udawat/IMU-9DoF-AHRS/README.md

IMU-9DoF-AHRS
=============

Explore Labs' 9 DoF IMU with Invensense's MPU-9150, Freescale Semiconductor's Pressure Sensor MPL3115A2 and Measurement Specialties' Humidity Sensor HTU21D and an optional GPS connector.
