udawat/IMU-9DoF-AHRS/IMU 9DoF AHRS Schematic.pdf

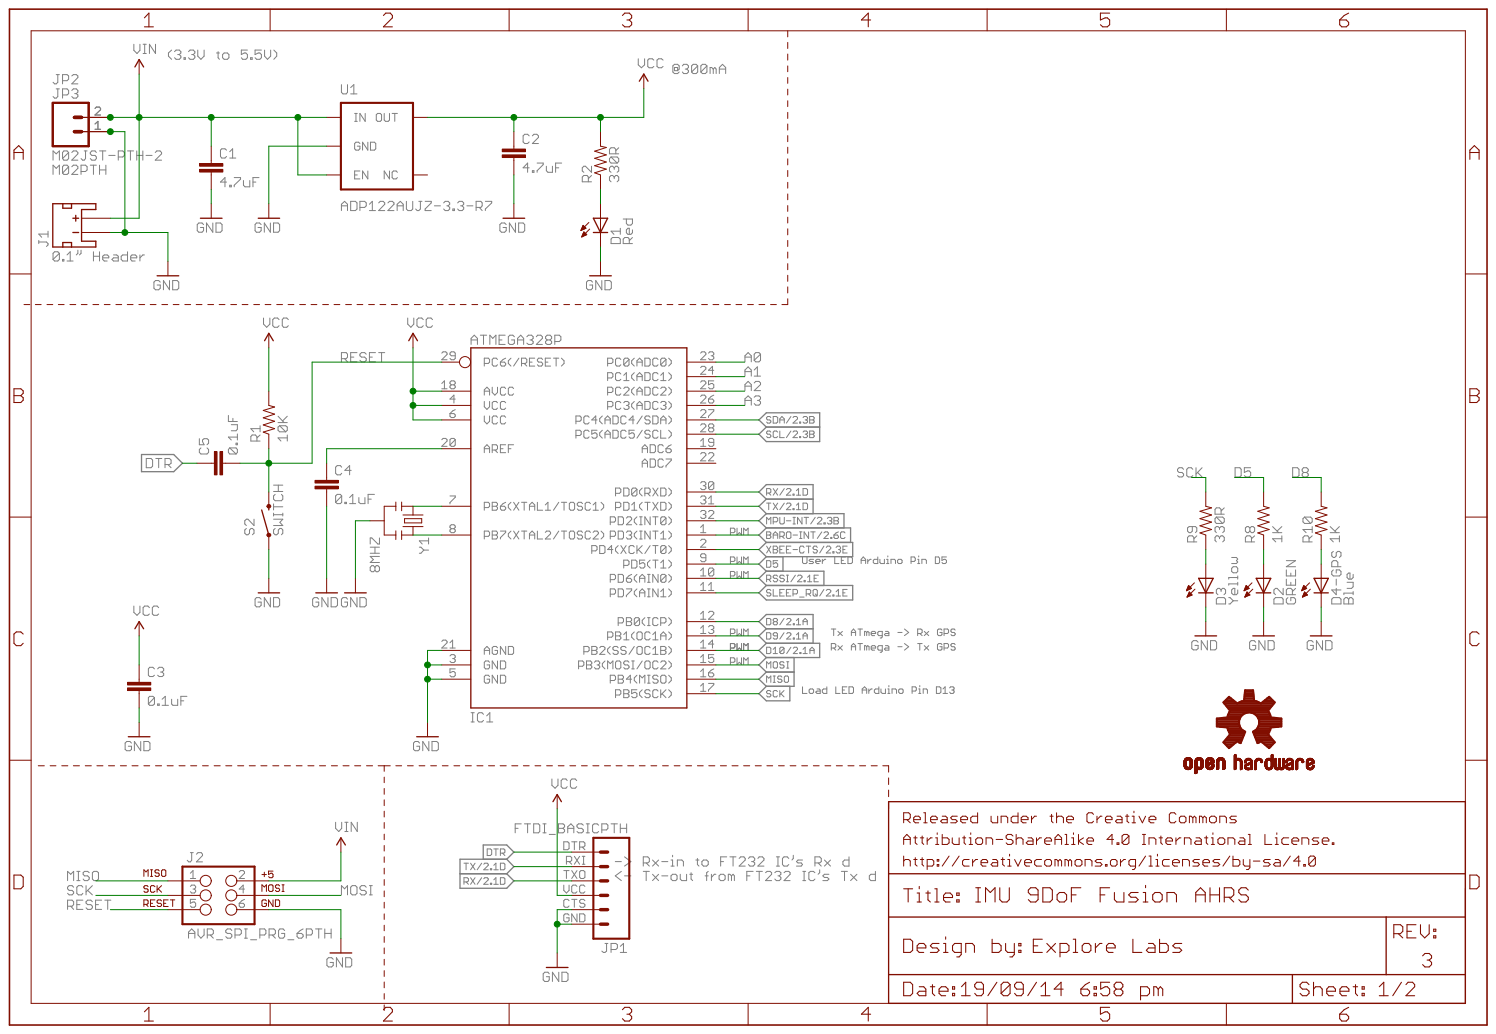
[picture p1: page 1]

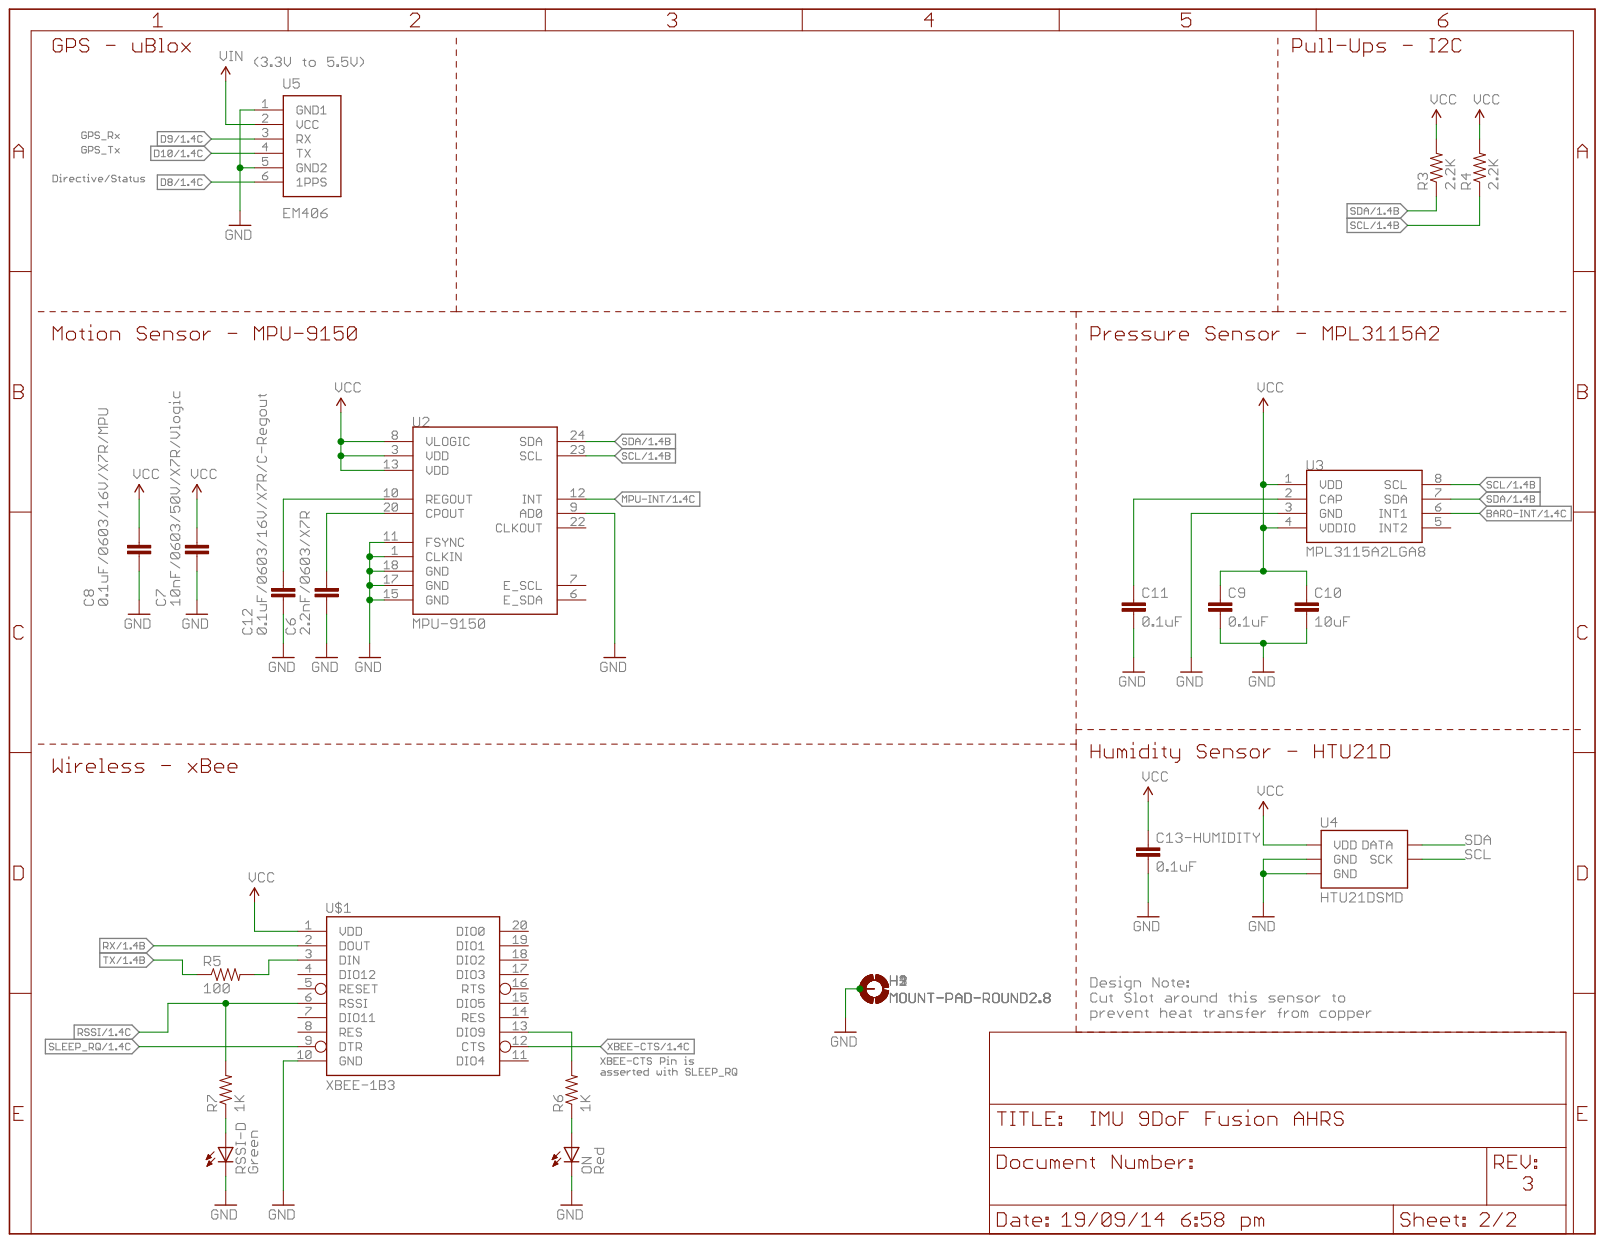
[picture p2: page 2]
