udawat/IMU-9DoF-AHRS/IMU 9DoF AHRS.brd

## EAGLE design IMU 9DoF AHRS.brd (2014-09-23)

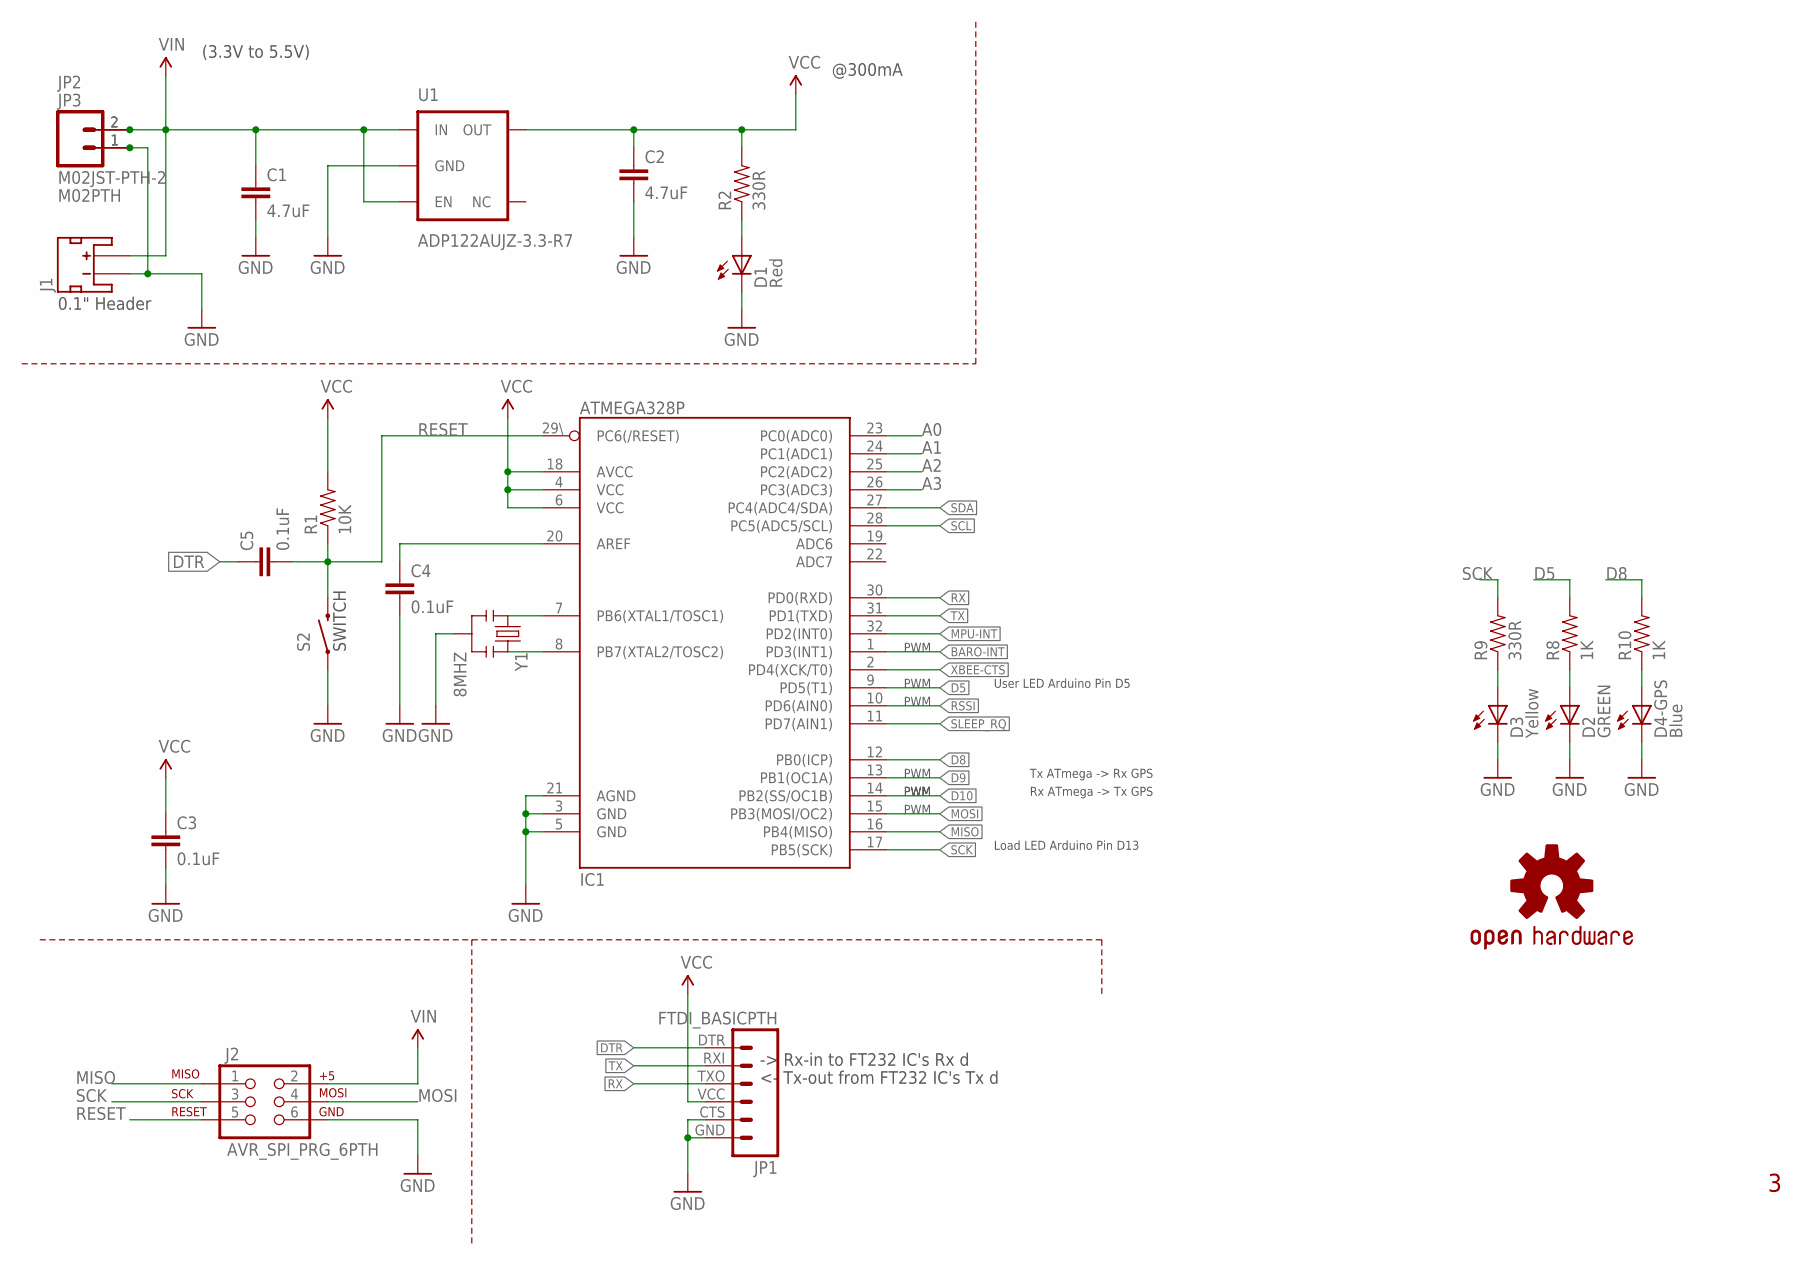
[picture p3: schematic IMU 9DoF AHRS.sch, sheet 1]

Parts:
C1, C2: 4.7uF; 0603-CAP
C3, C4, C5: 0.1uF; 0603-CAP
D1: Red; CHIPLED_0805
D2: GREEN; CHIPLED_0805
D3: Yellow; CHIPLED_0805
D4-GPS: Blue; CHIPLED_0805
IC1: ATMEGA328P; TQFP32-08
J1: JST_2MM_MALE; JST-2-SMD
J2: AVR_SPI_PRG_6PTH; 2X3
JP1: FTDI_BASICPTH; FTDI_BASIC
JP2: M02JST-PTH-2; JST-2-PTH
JP3: M02PTH; 1X02
LOGO4: OSHW-LOGOBOTTOM; OSHW-LOGO-M-BOTTOM
R1: 10K; 0603-RES
R2, R9: 330R; 0603-RES
R8, R10: 1K; 0603-RES
S2: SWITCH-MOMENTARY-2-SMD-1101NE; TACTILE-SWITCH-1101NE
U1: ADP122AUJZ-3.3-R7; SOT-23-5
Y1: 8MHZ; RESONATOR-SMD

Connections:
A0: IC1.23 (PC0(ADC0))
A1: IC1.24 (PC1(ADC1))
A2: IC1.25 (PC2(ADC2))
A3: IC1.26 (PC3(ADC3))
BARO-INT: IC1.1 (PD3(INT1)); also elsewhere on the board
D5: IC1.9 (PD5(T1)), R8.2
D8: IC1.12 (PB0(ICP)), R10.2; also elsewhere on the board
D9: IC1.13 (PB1(OC1A)); also elsewhere on the board
D10: IC1.14 (PB2(SS/OC1B)); also elsewhere on the board
DTR: C5.1, JP1.DTR (1)
GND: C1.2, C2.2, C3.2, C4.2, D1.C, D2.C, D3.C, D4-GPS.C, IC1.3 (GND), IC1.5 (GND), IC1.21 (AGND), J1.1 (-), J2.6, JP1.CTS (5), JP1.GND (6), JP2.1, JP3.1, S2.P$1 (1), U1.2 (GND), Y1.2; also elsewhere on the board
MISO: IC1.16 (PB4(MISO)), J2.1
MOSI: IC1.15 (PB3(MOSI/OC2)), J2.4
MPU-INT: IC1.32 (PD2(INT0)); also elsewhere on the board
unnamed: IC1.8 (PB7(XTAL2/TOSC2)), Y1.3
unnamed: IC1.7 (PB6(XTAL1/TOSC1)), Y1.1
unnamed: D3.A, R9.1
unnamed: C4.1, IC1.20 (AREF)
unnamed: D2.A, R8.1
unnamed: D1.A, R2.1
unnamed: D4-GPS.A, R10.1
RESET: C5.2, IC1.29\ (PC6(/RESET)), J2.5, R1.1, S2.P$2 (2)
RSSI: IC1.10 (PD6(AIN0)); also elsewhere on the board
RX: IC1.30 (PD0(RXD)), JP1.TXO (3); also elsewhere on the board
SCK: IC1.17 (PB5(SCK)), J2.3, R9.2
SCL: IC1.28 (PC5(ADC5/SCL)); also elsewhere on the board
SDA: IC1.27 (PC4(ADC4/SDA)); also elsewhere on the board
SLEEP_RQ: IC1.11 (PD7(AIN1)); also elsewhere on the board
TX: IC1.31 (PD1(TXD)), JP1.RXI (2); also elsewhere on the board
VCC: C2.1, C3.1, IC1.4 (VCC), IC1.6 (VCC), IC1.18 (AVCC), JP1.VCC (4), R1.2, R2.2, U1.5 (OUT); also elsewhere on the board
VIN: C1.1, J1.2 (+), J2.2, JP2.2, JP3.2, U1.1 (IN), U1.3 (EN); also elsewhere on the board
XBEE-CTS: IC1.2 (PD4(XCK/T0)); also elsewhere on the board

Notes on the sheet:
(3.3V to 5.5V)
@300mA
-> Rx-in to FT232 IC's Rx d
<- Tx-out from FT232 IC's Tx d
Load LED Arduino Pin D13
Tx ATmega -> Rx GPS
Rx ATmega -> Tx GPS
SWITCH
PWM
0.1" Header
User LED Arduino Pin D5

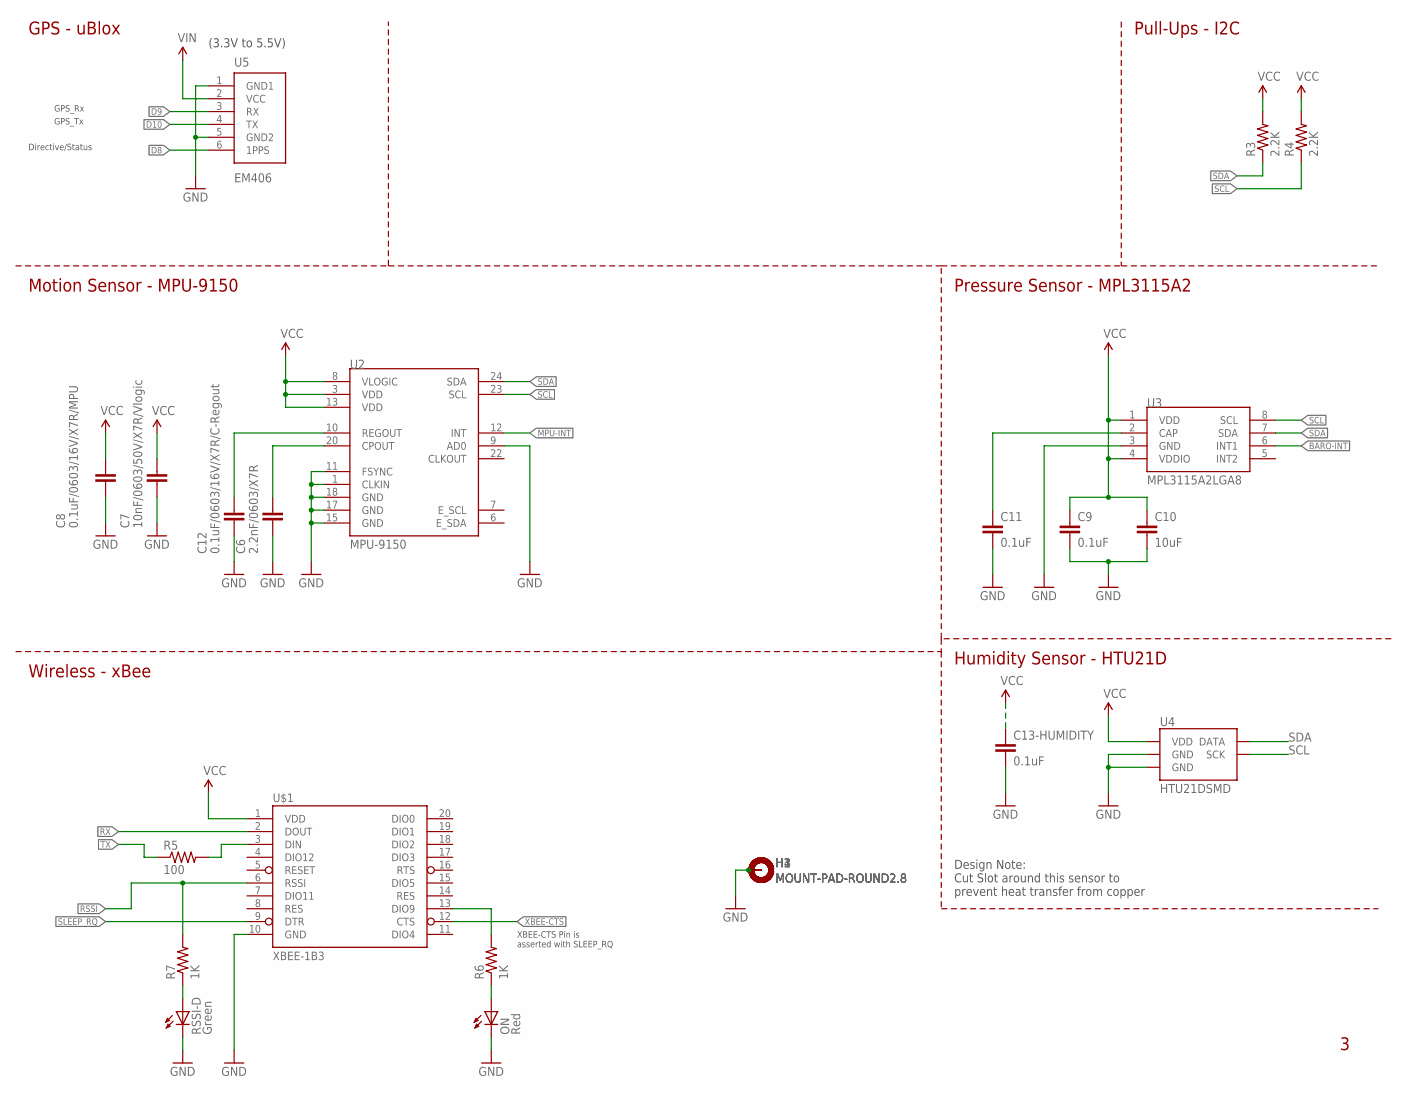
[picture p4: schematic IMU 9DoF AHRS.sch, sheet 2]

Parts:
C6: 2.2nF/0603/X7R; 0603-CAP
C7: 10nF/0603/50V/X7R/Vlogic; 0603-CAP
C8: 0.1uF/0603/16V/X7R/MPU; 0603-CAP
C9, C11, C13-HUMIDITY: 0.1uF; 0603-CAP
C10: 10uF; 0805
C12: 0.1uF/0603/16V/X7R/C-Regout; 0603-CAP
H1, H2, H3, H4: MOUNT-PAD-ROUND2.8; 2,8-PAD
ON: Red; CHIPLED_0805
R3, R4: 2.2K; 0603-RES
R5: 100; 0603-RES
R6, R7: 1K; 0603-RES
RSSI-D: Green; CHIPLED_0805
U2: MPU-9150QFN-24-NP; QFN-24-NP
U3: MPL3115A2LGA8; LGA8
U4: HTU21DSMD; HTU21D
U5: EM406
U$1: XBEE-1B3; XBEE-SMD

Connections:
BARO-INT: U3.6 (INT1); also elsewhere on the board
D8: U5.6 (1PPS); also elsewhere on the board
D9: U5.3 (RX); also elsewhere on the board
D10: U5.4 (TX); also elsewhere on the board
GND: C6.2, C7.2, C8.2, C9.2, C10.2, C11.2, C12.2, C13-HUMIDITY.2, H1.B2,8, H2.B2,8, H3.B2,8, H4.B2,8, ON.C, RSSI-D.C, U2.1 (CLKIN), U2.9 (AD0), U2.11 (FSYNC), U2.15 (GND), U2.17 (GND), U2.18 (GND), U3.3 (GND), U4.7 (GND), U4.GND, U5.1 (GND1), U5.5 (GND2), U$1.10 (GND); also elsewhere on the board
MPU-INT: U2.12 (INT); also elsewhere on the board
unnamed: C6.1, U2.20 (CPOUT)
unnamed: R5.2, U$1.3 (DIN)
unnamed: R7.1, RSSI-D.A
unnamed: R6.2, U$1.13 (DIO9)
unnamed: C12.1, U2.10 (REGOUT)
unnamed: ON.A, R6.1
unnamed: C11.1, U3.2 (CAP)
RSSI: R7.2, U$1.6 (RSSI); also elsewhere on the board
RX: U$1.2 (DOUT); also elsewhere on the board
SCL: R4.1, U2.23 (SCL), U3.8 (SCL), U4.SCK; also elsewhere on the board
SDA: R3.1, U2.24 (SDA), U3.7 (SDA), U4.DATA; also elsewhere on the board
SLEEP_RQ: U$1.9 (DTR); also elsewhere on the board
TX: R5.1; also elsewhere on the board
VCC: C7.1, C8.1, C9.1, C10.1, C13-HUMIDITY.1, R3.2, R4.2, U2.3 (VDD), U2.8 (VLOGIC), U2.13 (VDD), U3.1 (VDD), U3.4 (VDDIO), U4.VDD, U$1.1 (VDD); also elsewhere on the board
VIN: U5.2 (VCC); also elsewhere on the board
XBEE-CTS: U$1.12 (CTS); also elsewhere on the board

Notes on the sheet:
XBEE-CTS Pin is asserted with SLEEP_RQ
MPU-9150
Humidity Sensor - HTU21D
Pressure Sensor - MPL3115A2
Pull-Ups - I2C
Wireless - xBee
GPS_Rx
GPS_Tx
Directive/Status
Design Note: Cut Slot around this sensor to prevent heat transfer from copper
(3.3V to 5.5V)
GPS - uBlox
Motion Sensor - MPU-9150

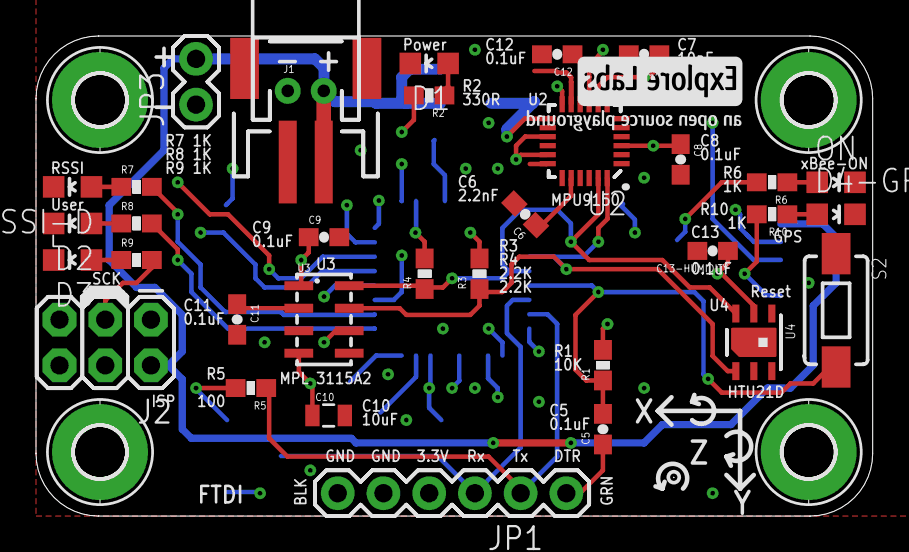
[picture p5: board IMU 9DoF AHRS.brd from above]

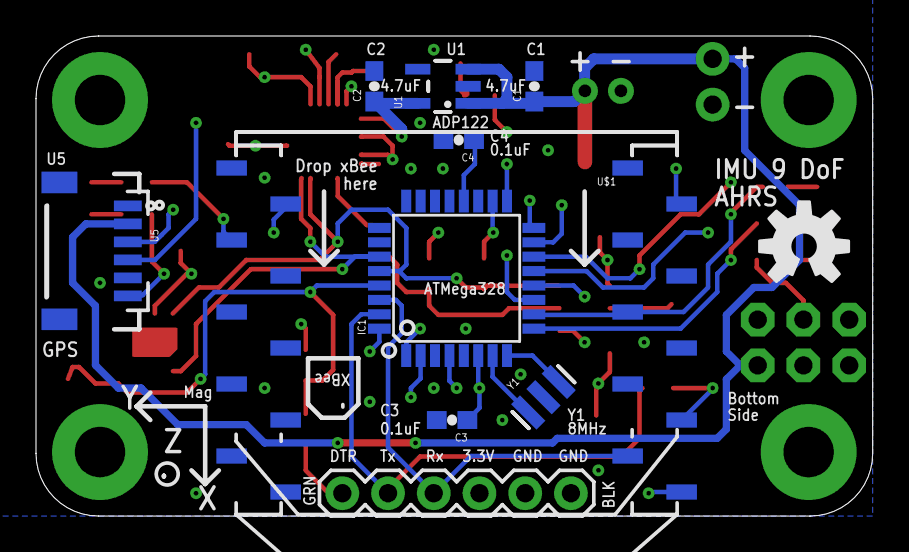
[picture p6: board IMU 9DoF AHRS.brd from below]

Board: 4 copper layers, 46.5 x 26.7 mm, 49 parts (10 on the bottom side), 35 nets.

Other parts of the board:
U$3: EXLABS_LOGO_0.25
