udawat/IMU-9DoF-AHRS/(commit log)

2014-08-20 schematic in .pdf format and license update
    [IMU 9DoF AHRS.sch]
2014-09-23 updated EAGLE files to latest revision
    updated EAGLE files to latest revision
    added Schematic in PDF format
    updated Gerber Data
    [IMU 9DoF AHRS.brd, IMU 9DoF AHRS.sch]
2014-09-30 updated schematic pdf
    scale factor adjust
2014-11-24 Added firmware for the board.
    .ino file can be viewed or uploaded using Arduino IDE 1.0.6
2015-12-22 Updated the MPU-9150 library with getMag function.
    Updated the MPU-6050 library with MPU-9150. Added getMag function in
    MPU-9150 library. Also, added I2Cdev library for single-source download.
2015-12-22 GPS LED fix
    The GPS LED on Pin 8 should not be defined as OUTPUT as the GPS module
    would loose its Fix.
    [IMU_9DoF_AHRS.ino]
