udawat/IMU-9DoF-AHRS/(notices)

Notices in the files:
parts and their libraries:
SparkFun-Aesthetics: Licensing: CC v3.0 Share-Alike You are welcome to use this library for commercial purposes.
11xLabs: Released under the Creative Commons
11xLabs: http://creativecommons.org/licenses/by-sa/4.0
